JohnnyLee-master250/Discrete-A741-Op-Amp/Manufacturing/BOM_Board1_741_PCB_2025-12-09.csv

No. | Quantity | Comment | Designator | Footprint | Value | Manufacturer Part | Manufacturer | Supplier Part | Supplier
1 | 1 | 33pF | C1 | C0805 | 33pF | CC0805JRNPO9BN330 | YAGEO(国巨) | C107115 | LCSC
2 | 2 | SS24 | D1,D2 | SMA_L4.3-W2.6-LS5.0-FD |  | SS24 | R+O(宏嘉诚) | C7420362 | LCSC
3 | 13 | BCP56-16 | Q1,Q3,Q5,Q6,Q7,Q10,Q11,Q14,Q15,Q16,Q17,Q19,Q20 | SOT-223-4_L6.5-W3.5-P2.30-LS7.0-BR |  | BCP56-16 | R+O(宏嘉诚) | C41375109 | LCSC
4 | 7 | BCP53-16 | Q2,Q4,Q8,Q9,Q12,Q13,Q18 | SOT-223-3_L6.7-W3.7-P2.30-LS7.0-BR |  | BCP53-16 | R+O(宏嘉诚) | C41375110 | LCSC
5 | 2 | 1kΩ | R1,R3 | R0805 | 1kΩ | 0805W8F1001T5E | UNI-ROYAL(厚声) | C17513 | LCSC
6 | 2 | 51kΩ | R2,R8 | R0805 | 51kΩ | 0805W8F5102T5E | UNI-ROYAL(厚声) | C17737 | LCSC
7 | 1 | 39kΩ | R4 | R0805 | 39kΩ | 0805W8F3902T5E | UNI-ROYAL(厚声) | C25826 | LCSC
8 | 2 | 4.7kΩ | R5,R6 | R0805 | 4.7kΩ | 0805W8F4701T5E | UNI-ROYAL(厚声) | C17673 | LCSC
9 | 1 | 7.5kΩ | R7 | R0805 | 7.5kΩ | 0805W8F7501T5E | UNI-ROYAL(厚声) | C17807 | LCSC
10 | 2 | 51Ω | R9,R11 | R0805 | 51Ω | 0805W8F510JT5E | UNI-ROYAL(厚声) | C17738 | LCSC
11 | 1 | 2.4kΩ | R10 | R0805 | 2.4kΩ | 0805W8F2401T5E | UNI-ROYAL(厚声) | C17526 | LCSC
12 | 1 | 10kΩ | R12 | 电位器 | 10kΩ | 3296W-1-103 | JIERR(捷而瑞) | C48997937 | LCSC
