JohnnyLee-master250/Discrete-A741-Op-Amp/Documentation/SCH_741_Schematic_2025-12-09.pdf

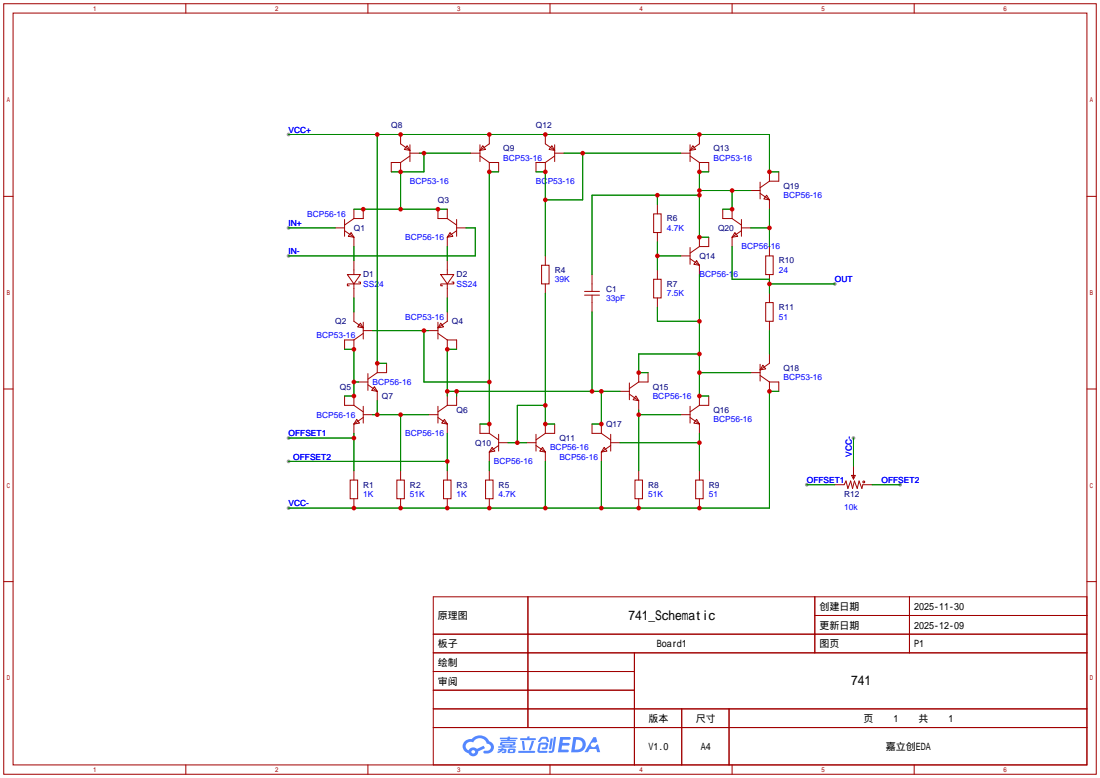
[picture p1: page 1]

原理图 | 741_Schematic | 创建日期 | 2025-11-30

更新日期 | 2025-12-09

板子 | Board1 | 图页 | P1

绘制 | | 741
审阅

V1.0 | A4 | 嘉立创EDA
