JohnnyLee-master250/Discrete-A741-Op-Amp/Documentation/PCB_741_PCB_2025-12-09.pdf

+-

uA741

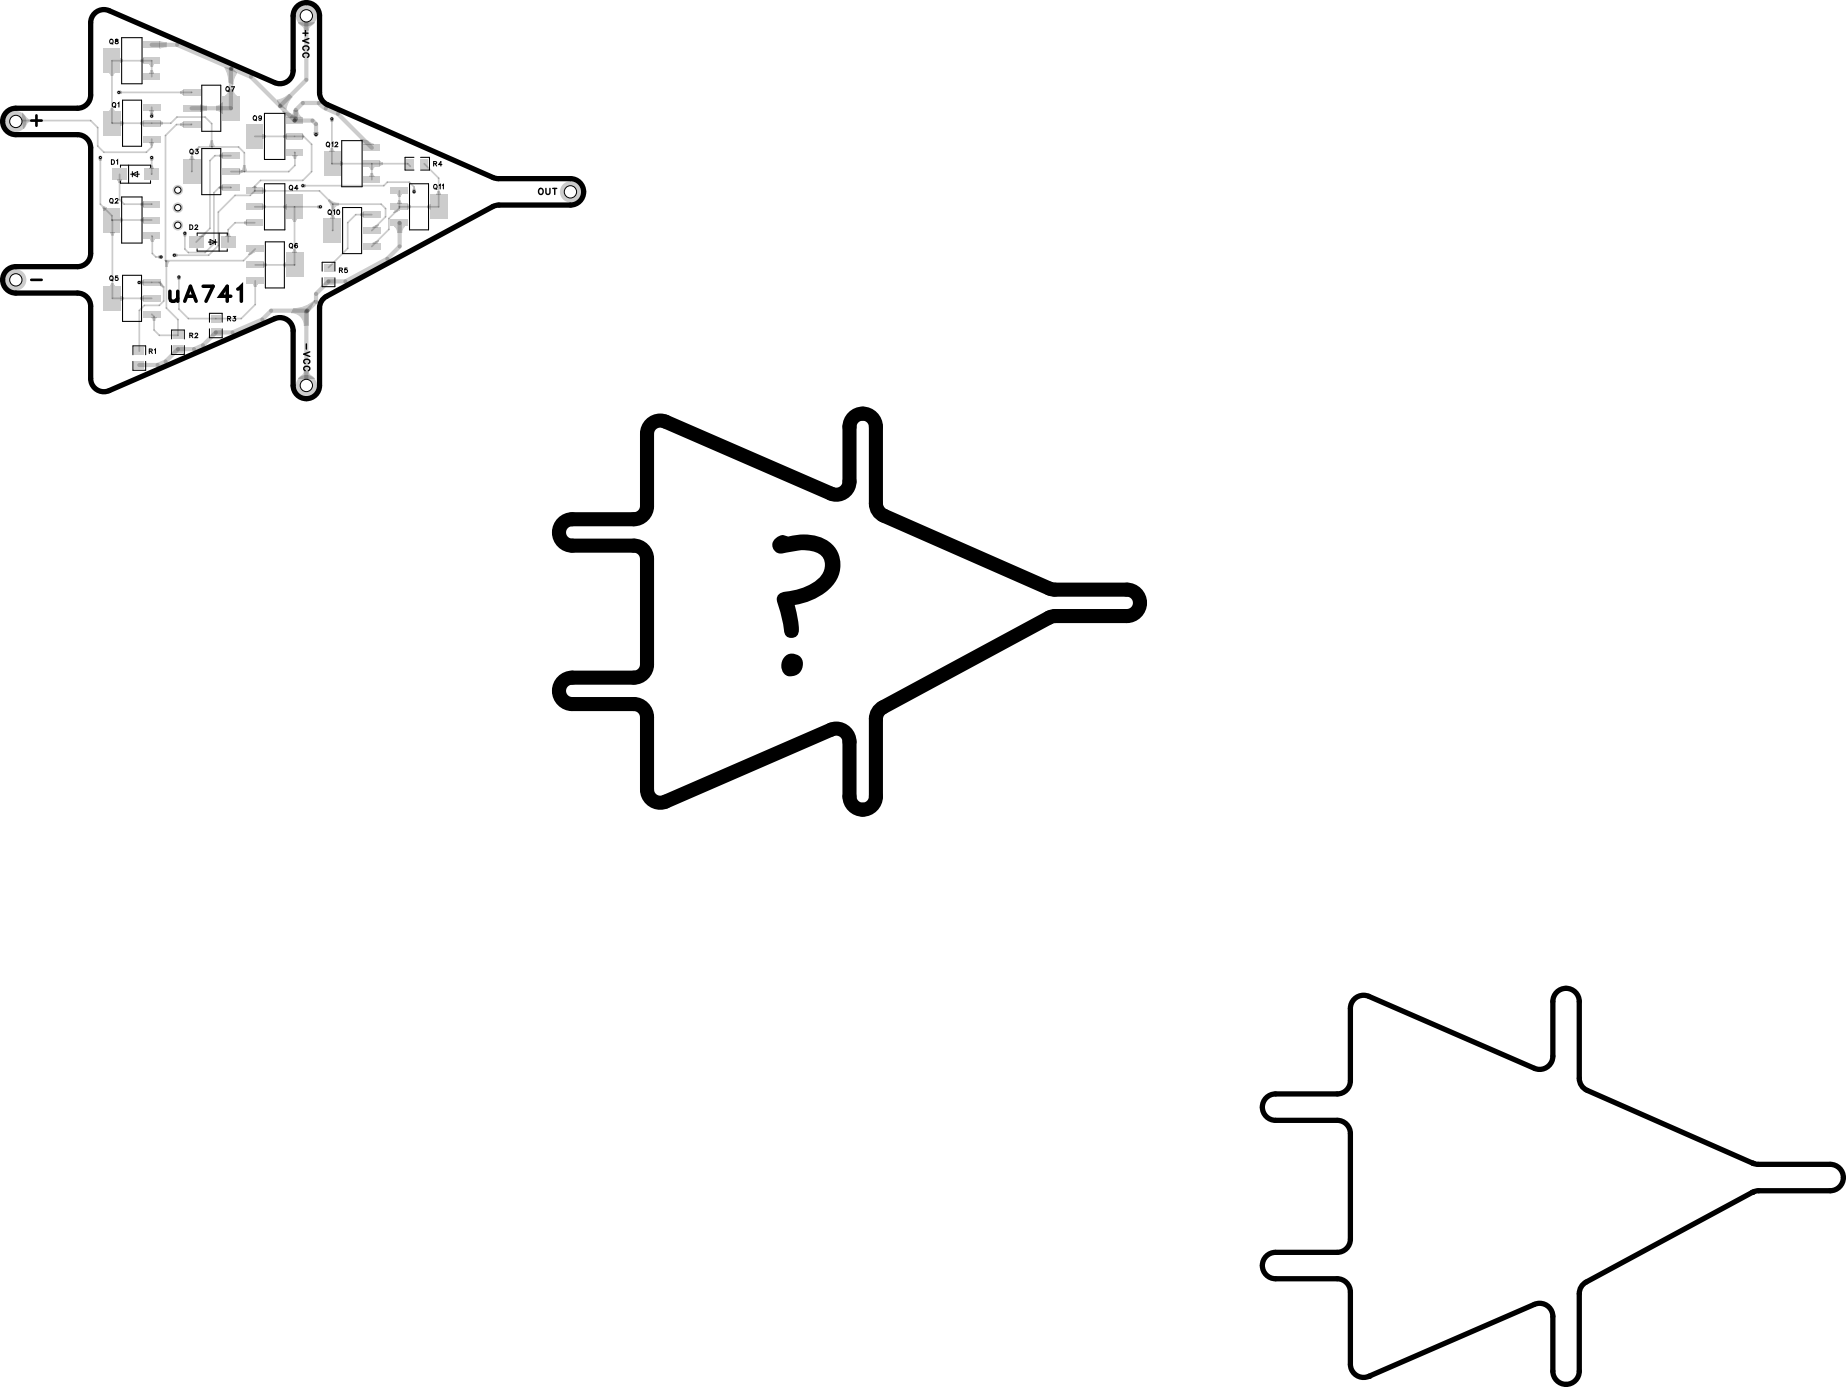
[picture p2: page 1]

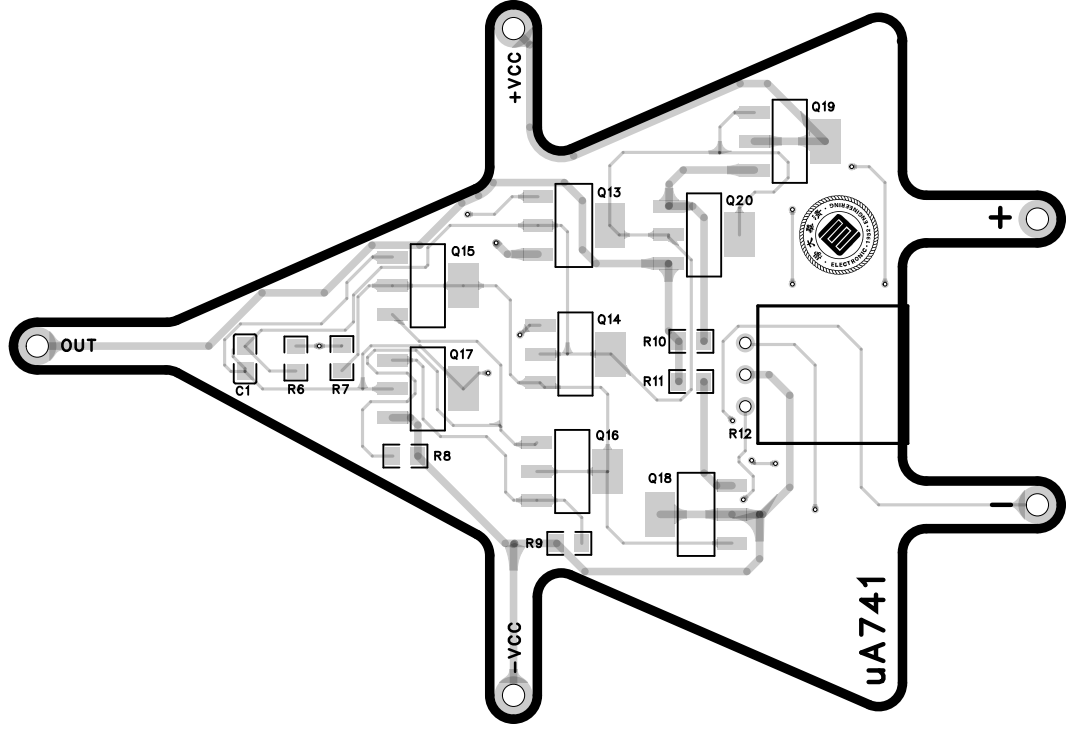
[picture p3: page 2]
