JohnnyLee-master250/Discrete-A741-Op-Amp/(list of files, drawings)

Other design files:
ProPrj_741_2025-12-09.epro
