JohnnyLee-master250/Discrete-A741-Op-Amp/(commit log)

2025-12-09 Add files via upload
    The Altium formatted files may contain uncertain error due to the format transformation. Please check carefully before manufacture.
    [ProPrj_741_2025-12-09.epro]
2026-05-06 Normalize project documentation and release files
    [BOM_Board1_741_PCB_2025-12-09.csv, PickAndPlace_741_PCB_2025-12-09.xlsx]
